arber333/ESP32-VCU/ESP32 VCU pinout.jpg

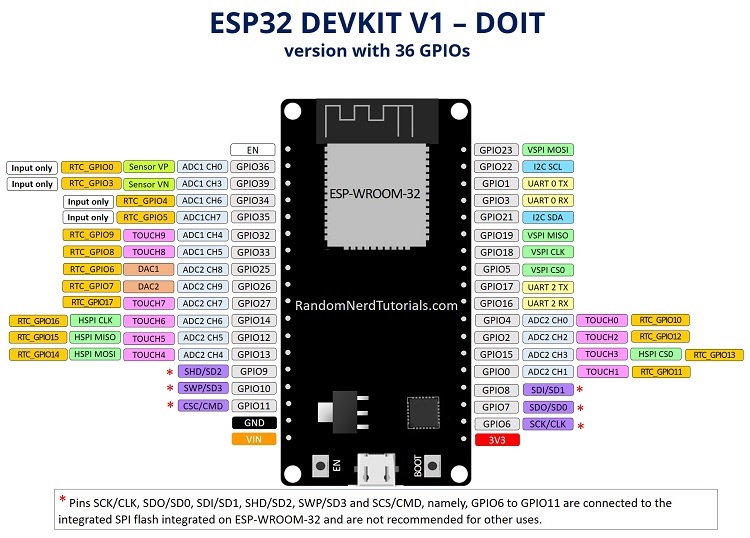
ESP32 VCU pinout.jpg
