arber333/ESP32-VCU/VCU pinout V2_5.pdf

1 | Out1 | START | PP | ENABLE | AC ON | PWM3 | OUT5 | GND | 8
9 | Out2 | TH2 | CAN L | BMS | REV | PWM2 | OUT4 | 5V | 16
17 | Out3 | TH1 | CAN H | HEATER | FWD | PWM1 | Cp | 12V | 24

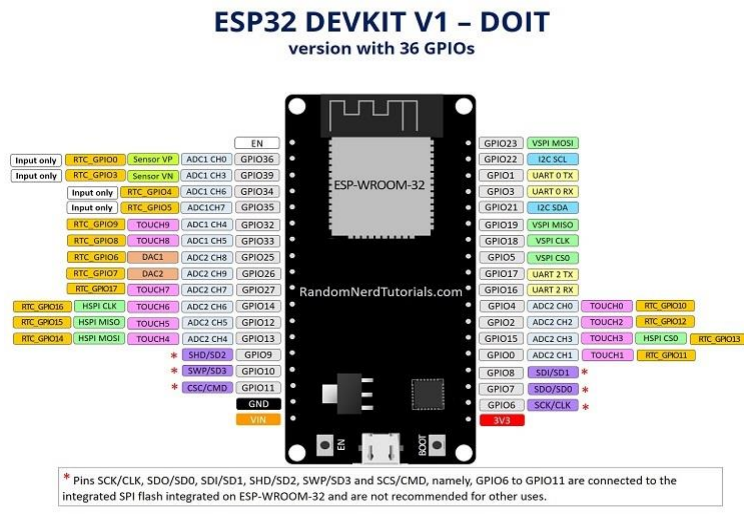
[picture p4: figure]

FWD | I18 | Input
REV | I19 | Input
AC compressor | I32 | Input
HEATER | I36 | Input
BMS | I34 | Input
ENABLE | I35 | Input
PP | I39 | Input
START | I23 | Input
CAN L | G16 | CANrx
CAN H | G17 | CANtx
Out1 | G26 | Output
Out2 | D27 | Output
Out3 | D12 | Output
Out4 | G0 | Output
Out5 | G4 | Output
PWM1 | G14 | PWM
PWM2 | G25 | PWM
PWM3 | G33 | PWM
BUZZ | G13 | buzzer
Cp signal | G3 | Input
Cp relay | G2 | Output
Throttle1 | AD1 | Analog
Throttle2 | AD2 | Analog
12Vsense | AD0 | Analog

## VCU pin out V2.5

24P connector on cable

Function VCU
