arber333/ESP32-VCU/ESP32 VCU SPI pinout.jpg

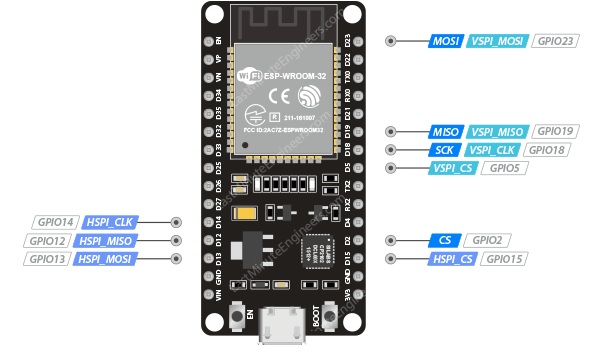
ESP32 VCU SPI pinout.jpg
