arber333/ESP32-VCU/ESP32-UART-Pins.png

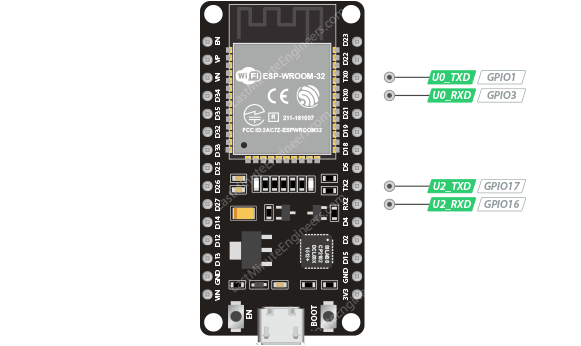
ESP32-UART-Pins.png
