arber333/ESP32-VCU/(list of files, drawings)

Other design files:
ESP32 shield_V1.pcb
ESP32 shield_V2_4.pcb
ESP32 shield_V2_5.pcb
