arber333/ESP32-VCU/20260111_234845.jpg

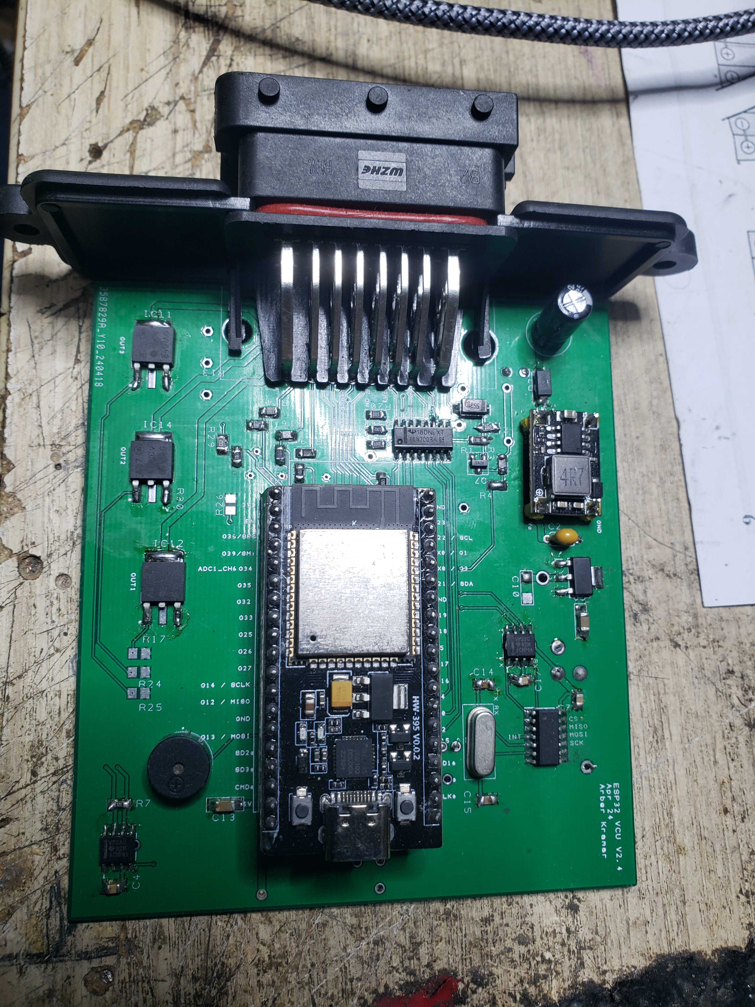
20260111_234845.jpg
