arber333/ESP32-VCU/20260111_234837.jpg

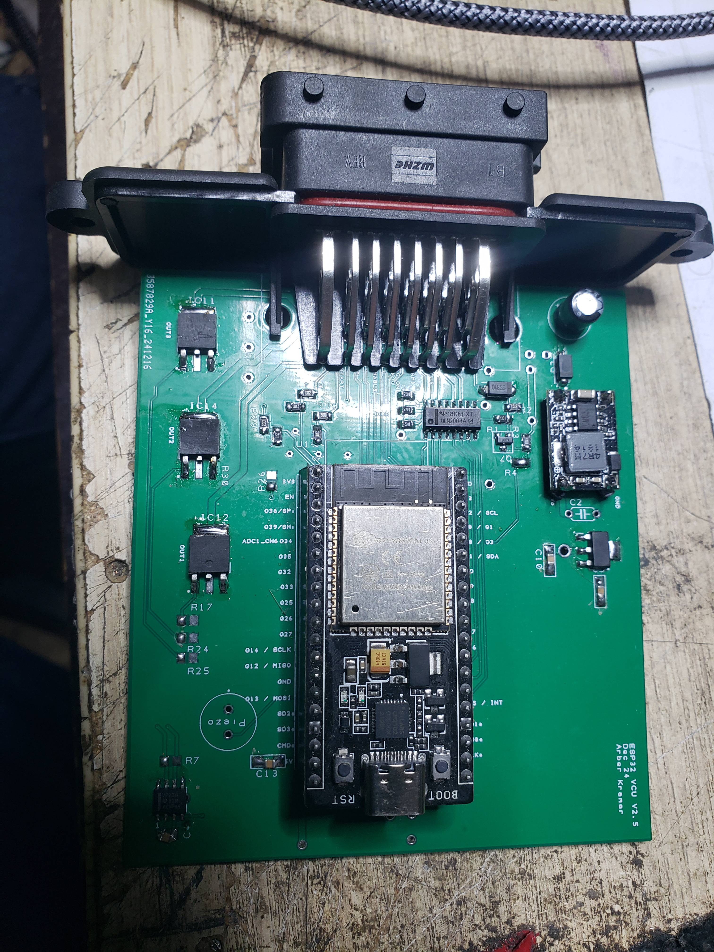
20260111_234837.jpg
